gluap/obsdisplay_esp32/README.md

> [!NOTE]
> This repo now lives [here](https://github.com/openbikesensor/neopixeldisplay_esp32)
