gluap/obsdisplay_esp32/media/cases_screensaver.jpg

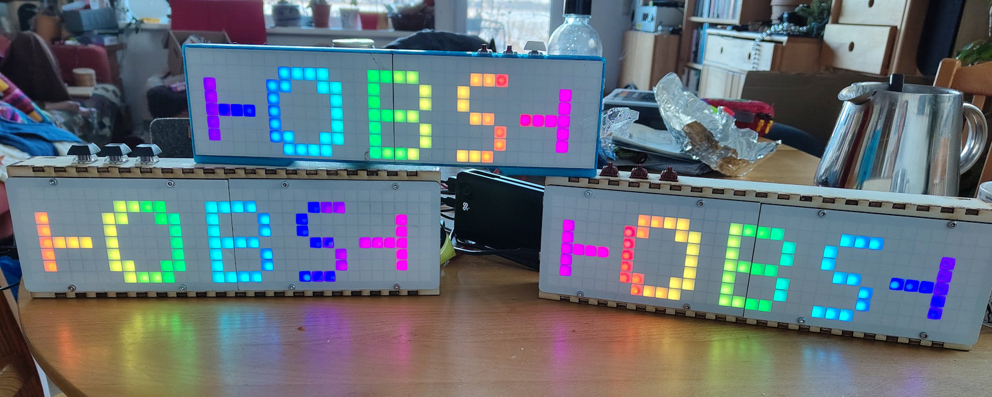
media/cases_screensaver.jpg
