gluap/obsdisplay_esp32/case and wiring/case-3DPrint/bifrost-led-matrix-case-model_files/case_split_right_usb_c.stl

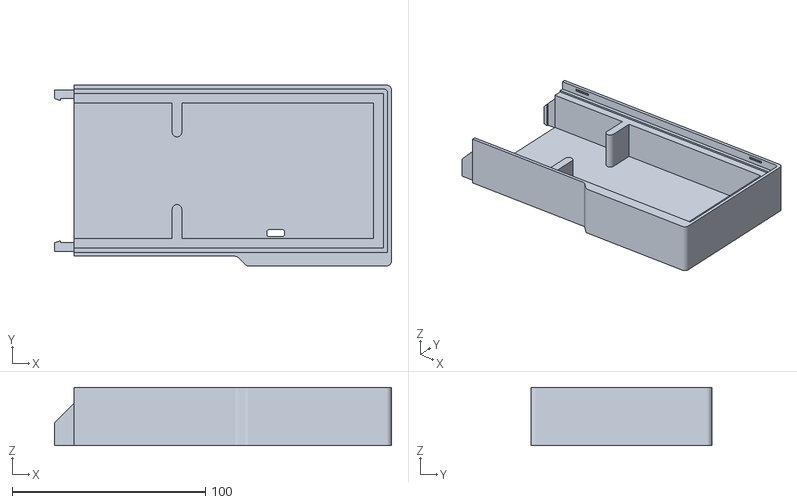
[picture p2: CAD file, 2026-01-01]
case and wiring/case-3DPrint/bifrost-led-matrix-case-model_files/case_split_right_usb_c.stl
174.2 x 93.5 x 30.0
