gluap/obsdisplay_esp32/case and wiring/case-3DPrint/case_split_usb_c_right.stl

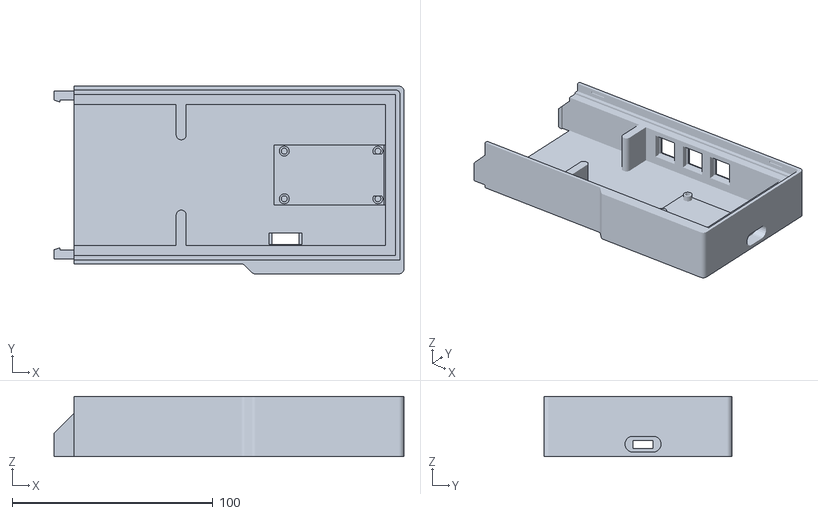
[picture p3: CAD file, 2026-01-01]
case and wiring/case-3DPrint/case_split_usb_c_right.stl
174.2 x 93.5 x 30.0
