gluap/obsdisplay_esp32/case and wiring/case-Lasercut/8x32_neopixel_diffusor.stl

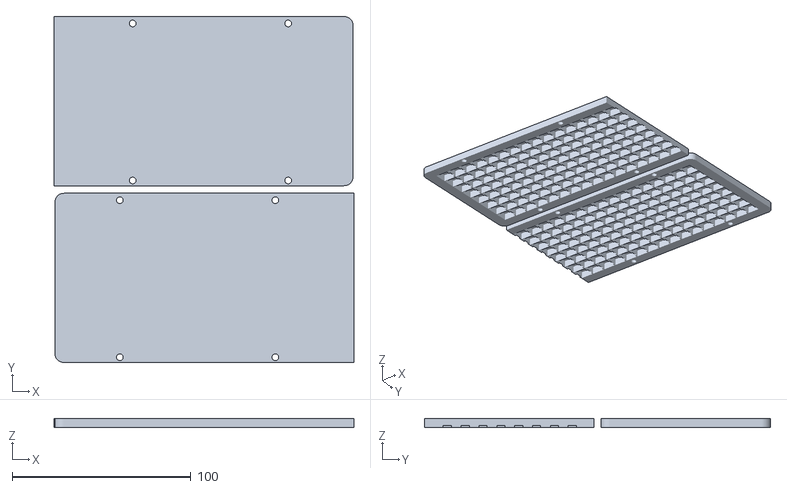
[picture p4: CAD file, 2026-01-02]
case and wiring/case-Lasercut/8x32_neopixel_diffusor.stl
167.8 x 193.8 x 5.00
