gluap/obsdisplay_esp32/case and wiring/case-3DPrint/bifrost-led-matrix-case-model_files/case_split_left.stl

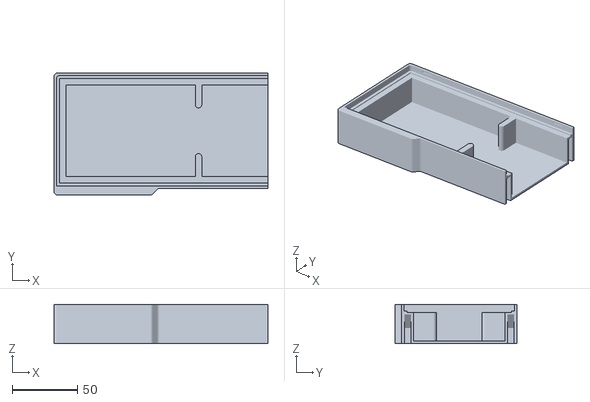
[picture p5: CAD file, 2026-01-01]
case and wiring/case-3DPrint/bifrost-led-matrix-case-model_files/case_split_left.stl
164.2 x 93.5 x 30.0
