gluap/obsdisplay_esp32/case and wiring/case-3DPrint/bifrost-led-matrix-case-model_files/STEP/diffuser_right.step

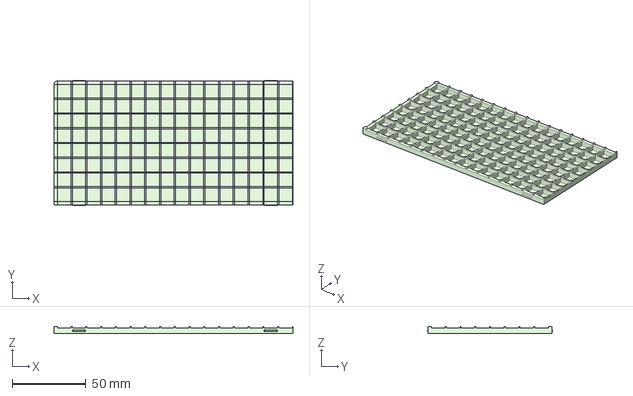
[picture p6: CAD file, 2026-01-01]
case and wiring/case-3DPrint/bifrost-led-matrix-case-model_files/STEP/diffuser_right.step
162.0 x 85.0 x 5.00 mm
