gluap/obsdisplay_esp32/case and wiring/case-Lasercut/esp32mount.stl

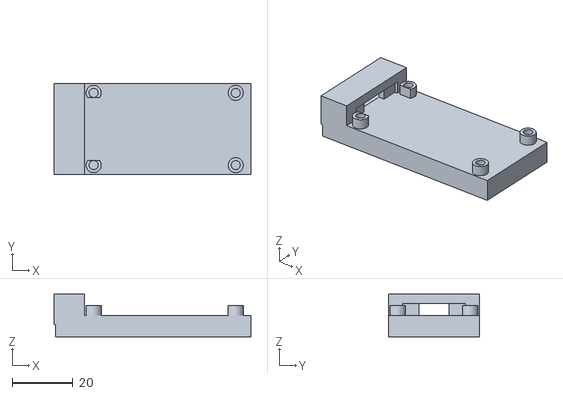
[picture p7: CAD file, 2026-01-02]
case and wiring/case-Lasercut/esp32mount.stl
64.6 x 29.7 x 14.0
