gluap/obsdisplay_esp32/case and wiring/case-3DPrint/bifrost-led-matrix-case-model_files/diffuser.stl

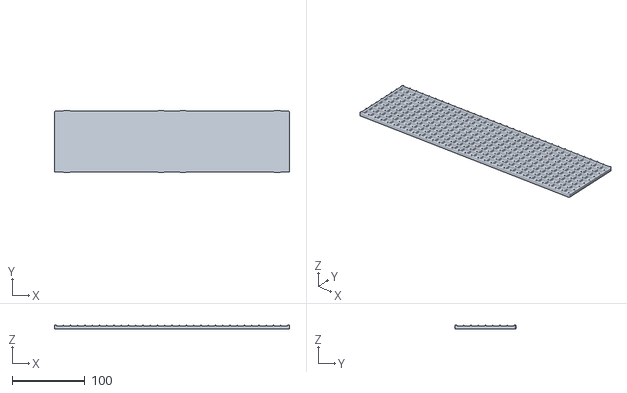
[picture p8: CAD file, 2026-01-01]
case and wiring/case-3DPrint/bifrost-led-matrix-case-model_files/diffuser.stl
324.0 x 85.0 x 5.00
