gluap/obsdisplay_esp32/case and wiring/case-3DPrint/bifrost-led-matrix-case-model_files/STEP/case_usb_c_no_split.step

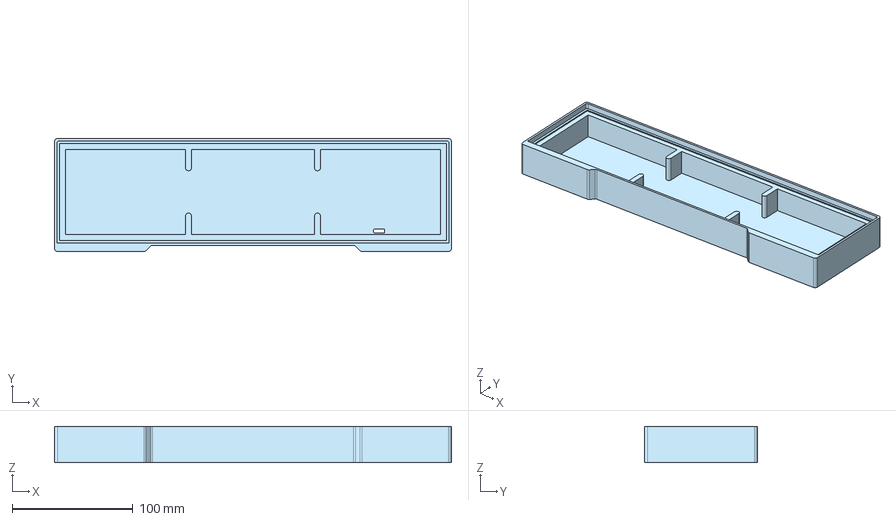
[picture p9: CAD file, 2026-01-01]
case and wiring/case-3DPrint/bifrost-led-matrix-case-model_files/STEP/case_usb_c_no_split.step
328.5 x 93.5 x 30.0 mm
