gluap/obsdisplay_esp32/case and wiring/case-Lasercut/esp32mount.scad

include <../include.scad>
esp32mount(4);
