gluap/obsdisplay_esp32/(list of files, cad)

Other CAD files:
case and wiring/case-3DPrint/bifrost-led-matrix-case-model_files/STEP/case_usb_c_right.step
case and wiring/case-3DPrint/bifrost-led-matrix-case-model_files/STEP/case_usb_c_left.step
case and wiring/case-3DPrint/bifrost-led-matrix-case-model_files/diffuser_split_right.stl
case and wiring/case-3DPrint/bifrost-led-matrix-case-model_files/diffuser_split_left.stl
case and wiring/case-3DPrint/bifrost-led-matrix-case-model_files/STEP/diffuser_no_split.step
case and wiring/case-3DPrint/bifrost-led-matrix-case-model_files/STEP/diffuser_left.step
