gluap/obsdisplay_esp32/case and wiring/README.md

# Hardware manual
Chose between the two variants:

Lasercut version [building instructions](case-Lasercut):<br/>
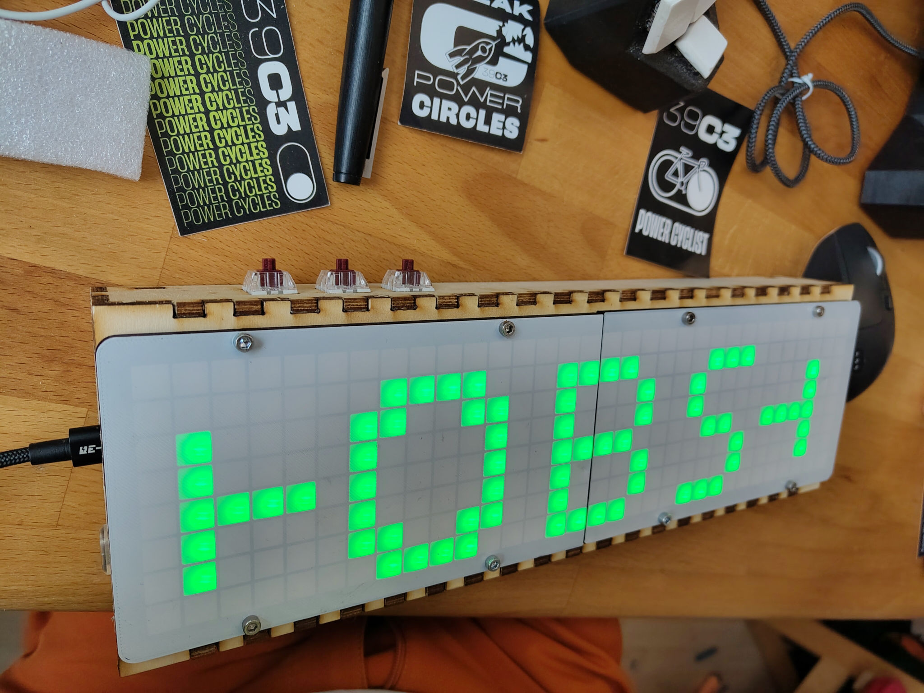
[picture p10: media/Lasercut_case.jpg]


Fully 3D-printed version [building instructions](case-3DPrint):<br/>
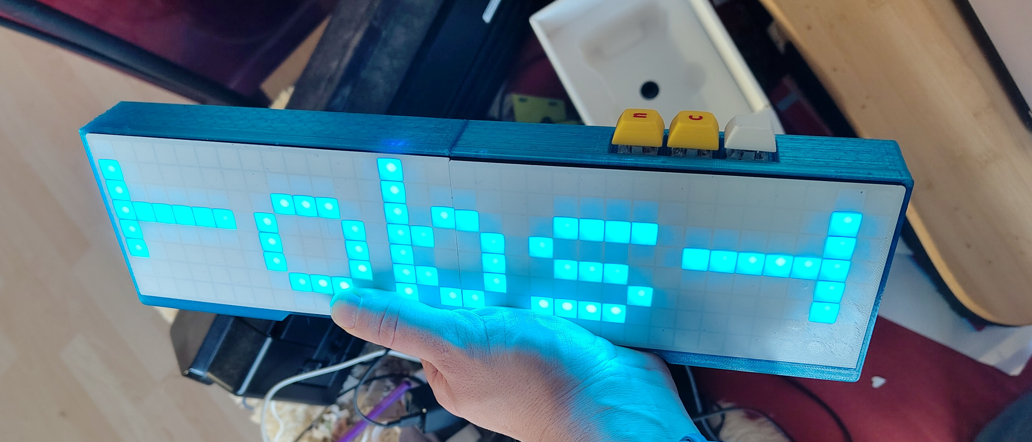
[picture p11: media/3DPrint_case.jpg]


## Required parts:

- ESP32 module, 30-Pin version. (the same ESP module used in the OpenBikeSensor)
- 3 cherry type keyswitches and matching keycaps
- [USB-C power module](https://www.amazon.de/dp/B0F2MNT26V)
- some wire (about 40cm)
- crimping supplies ([see below](#crimping-supplies))
- for the 3D-printed case version:
    - 2x m3x8mm bolts
    - superglue
    - [the 3D-printed parts](case-3DPrint)
- for the partly-lasercut case version:
    - wood glue
    - hot glue
    - 8x m3x12mm bolts for securing the display
    - 8x m3 nuts for securing the display [standart OpenBikeSensor nut, you might already have this]
    - 8x m3x8mm bolts. 2x for ESP32, 4x for back cover.  [standard OpenBikeSensor bolt, you might already have this]
    - [the lasercut and 3D-Printed parts for this case](case-Lasercut)

> [!NOTE]
> If you have crimping pliers, you might have all the crimps and connectors required at hand in the box with your pliers.

### Crimping Supplies
- about 12 JST-XH Crimps (BXH-001T-P0.6)
- about 2 male JST-XH Crimps
- 3-Pin JST-XH Board connector (for the display pins on the ESP32) [male]
- 2-Pin JST-XH connector (for the display power cable) [female]
- 2-Pin **Male** JST-XH connector (for the usb power module) [male]
- 3-Pin JST-XH connector (for the display cable) [female]
- 5-Pin JST-XH Board connector (for the button pins on the ESP32) [male]
- 5-Pin JST-XH connector (for the button cable) [female]

## Required Tools
- JST-XH Crimping pliers.
- soldering iron and soldering supplies.
