gluap/obsdisplay_esp32/(commit log)

2025-12-22 Initial commit (display, 3 buttons on pins #2,#4, #15 to 3v3, display on vcc,gnd,GPIO13
2026-01-01 Add case, add some documentation
    [8x32_neopixel_diffusor.scad, case_split_left.stl, case_split_right_usb_c.stl, case_split_usb_c_right.stl, case_usb_c_left.step, case_usb_c_no_split.step, case_usb_c_right.step, diffuser.stl]
2026-01-02 Some refactoring, allow customizing led string direction.
    [8x32_neopixel_diffusor.scad, case_split_usb_c_right.scad, esp32mount.scad, esp32mount.stl, include.scad]
2026-01-02 add lasercut case image
2026-01-02 Add lasercut svg and adapt readme.
2026-01-02 Add more documentation and images.
    [8x32_neopixel_diffusor.stl]
2026-01-10 Fix single pixel issue; reduce verbosity on tty
    [main.cpp]
